Ahilnandan/Hydration_Monitoring/Hardware/Circuit_diagram.jpeg

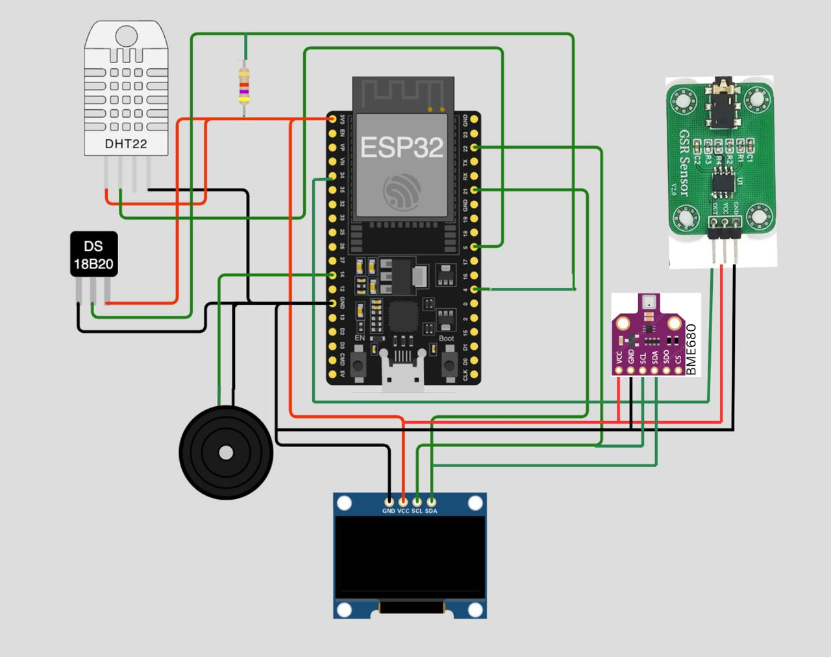
Hardware/Circuit_diagram.jpeg
