Ahilnandan/Hydration_Monitoring/Hardware/Diagram_for_Final_Product.jpg

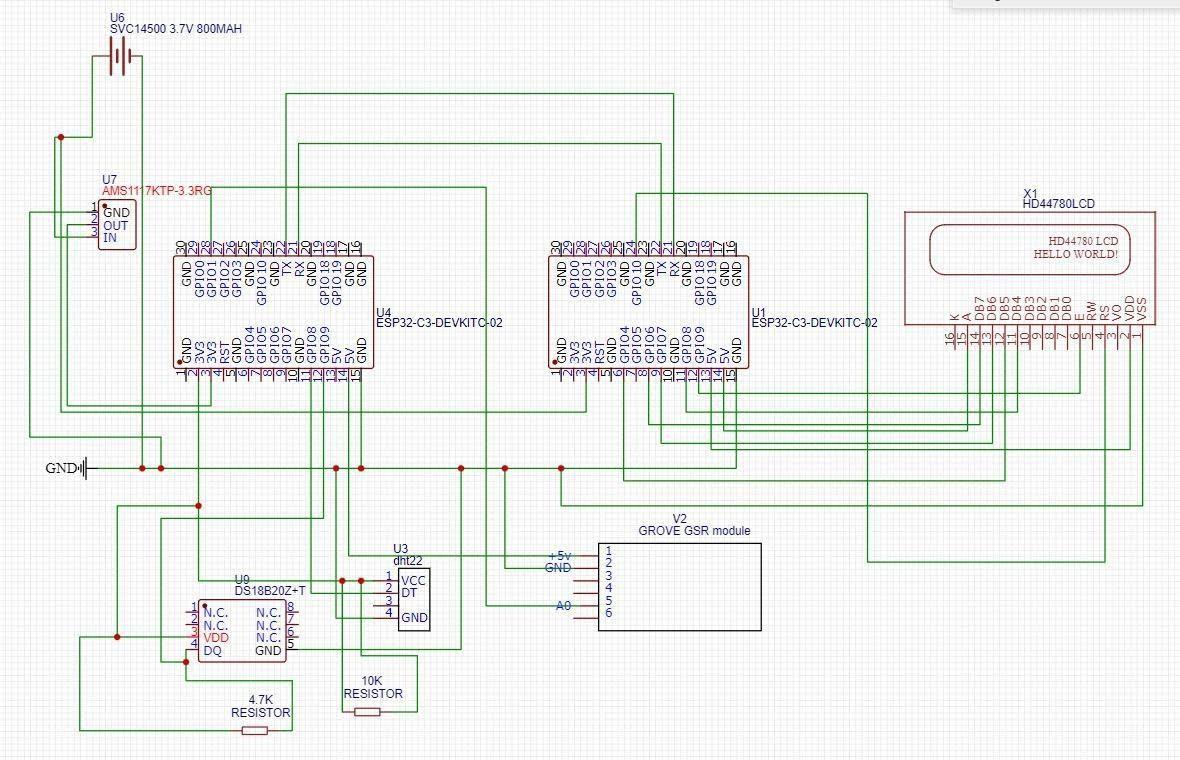
Hardware/Diagram_for_Final_Product.jpg
