Ahilnandan/Hydration_Monitoring/Hardware/Pin_Connection.jpeg

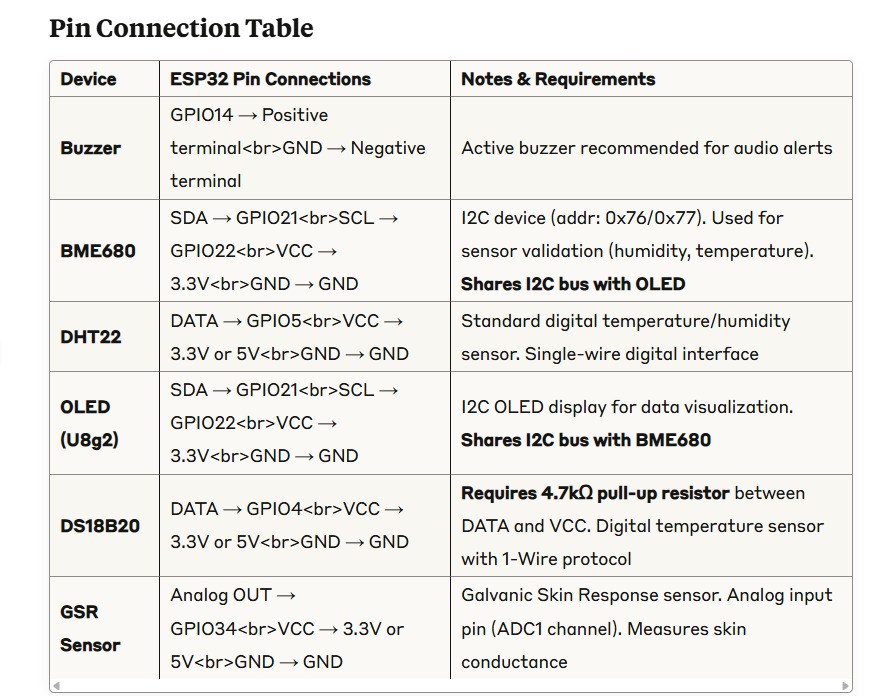
Hardware/Pin_Connection.jpeg
