Ahilnandan/Hydration_Monitoring/Hardware/Bill Of Materials.jpeg

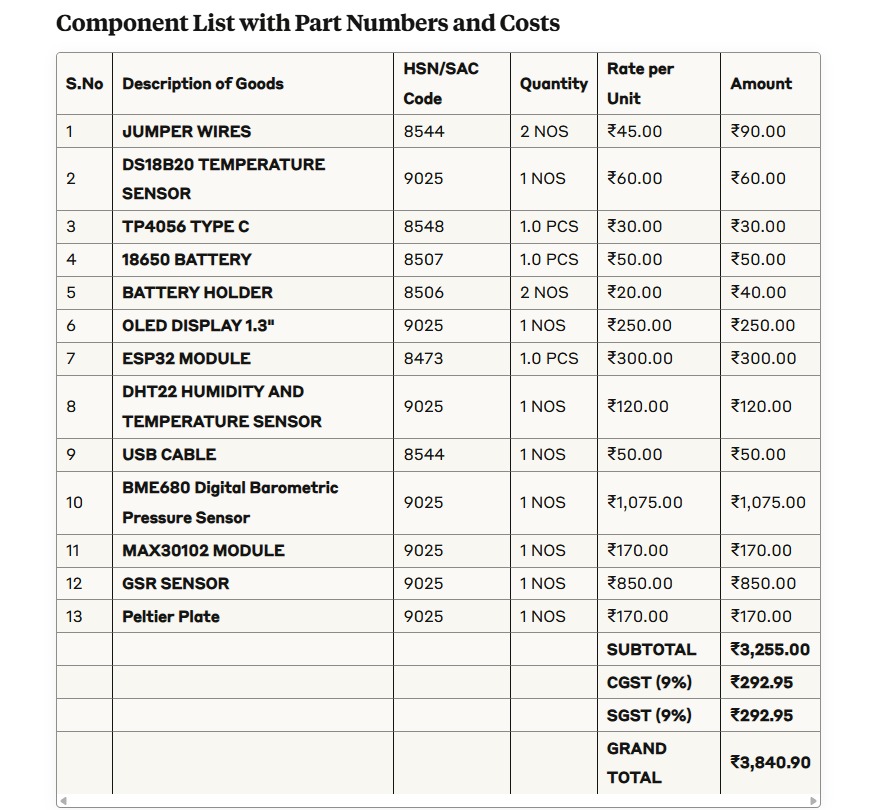
Hardware/Bill Of Materials.jpeg
