Ahilnandan/Hydration_Monitoring/drift_test_12h/log.csv

Time(ms) | GSR | DHT22_Temp(C) | DHT22_Hum(%) | DS18B20_Temp(C) | BME680_Temp(C) | BME680_Hum(%)
1 | 208 | 26.4 | 75.9 | 28.06 | 26.77 | 77.08
8 | 207 | 26.4 | 75.9 | 28.06 | 26.77 | 76.94
15 | 192 | 26.5 | 76 | 28.06 | 26.77 | 76.85
22 | 208 | 26.5 | 75.9 | 28 | 26.77 | 76.74
29 | 207 | 26.5 | 76 | 28.06 | 26.77 | 76.64
36 | 206 | 26.5 | 76 | 28 | 26.78 | 76.6
43 | 205 | 26.5 | 75.9 | 28 | 26.78 | 76.58
50 | 201 | 26.5 | 76 | 28.06 | 26.79 | 76.76
57 | 214 | 26.5 | 76 | 28.06 | 26.79 | 77.03
64 | 206 | 26.5 | 75.9 | 28.06 | 26.8 | 77.12
71 | 208 | 26.5 | 76 | 28 | 26.81 | 77.35
78 | 208 | 26.5 | 75.9 | 28.06 | 26.81 | 77.21
85 | 208 | 26.5 | 75.9 | 28.06 | 26.81 | 77.05
92 | 207 | 26.5 | 75.9 | 28.06 | 26.82 | 76.97
99 | 188 | 26.5 | 75.9 | 28 | 26.83 | 76.88
106 | 203 | 26.5 | 75.8 | 28.06 | 26.83 | 76.82
113 | 203 | 26.5 | 75.8 | 28.06 | 26.83 | 76.76
120 | 207 | 26.5 | 75.8 | 28.06 | 26.83 | 76.7
127 | 206 | 26.5 | 75.7 | 28.06 | 26.83 | 76.65
134 | 198 | 26.5 | 75.7 | 28.06 | 26.83 | 76.62
141 | 210 | 26.5 | 75.7 | 28.06 | 26.83 | 76.6
148 | 234 | 26.5 | 75.7 | 28 | 26.83 | 76.58
155 | 206 | 26.5 | 75.7 | 28.06 | 26.82 | 76.53
162 | 199 | 26.5 | 75.6 | 28 | 26.82 | 76.49
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
