Ahilnandan/Hydration_Monitoring/test_logs/DS18B20/Temperature_accuracy.csv

Time(s) | DS18B20_Temp (Â°C) | BME680_Temp (Â°C)
1 | 28.25 | 28.58
6 | 28.25 | 28.3
11 | 28.25 | 28.06
16 | 28.25 | 27.88
21 | 28.31 | 27.73
26 | 28.31 | 27.62
31 | 28.31 | 27.53
36 | 28.25 | 27.47
41 | 28.25 | 27.42
46 | 28.31 | 27.38
51 | 28.25 | 27.35
56 | 28.25 | 27.32
61 | 28.25 | 27.3
66 | 28.25 | 27.29
71 | 28.25 | 27.28
76 | 28.31 | 27.27
81 | 28.25 | 27.26
86 | 28.25 | 27.26
91 | 28.25 | 27.25
96 | 28.31 | 27.25
101 | 28.31 | 27.24
106 | 28.25 | 27.24
111 | 28.31 | 27.24
116 | 28.25 | 27.24
121 | 28.25 | 27.23
126 | 28.25 | 27.23
131 | 28.25 | 27.23
136 | 28.25 | 27.23
141 | 28.25 | 27.23
146 | 28.25 | 27.23
151 | 28.25 | 27.22
156 | 28.25 | 27.22
161 | 28.25 | 27.22
166 | 28.25 | 27.22
171 | 28.25 | 27.22
176 | 28.25 | 27.22
181 | 28.25 | 27.22
186 | 28.25 | 27.21
191 | 28.25 | 27.21
196 | 28.25 | 27.21
201 | 28.19 | 27.21
206 | 28.19 | 27.21
211 | 28.25 | 27.21
216 | 28.25 | 27.21
221 | 28.25 | 27.21
226 | 28.25 | 27.2
231 | 28.25 | 27.2
236 | 28.25 | 27.2
241 | 28.19 | 27.2
246 | 28.25 | 27.2
251 | 28.25 | 27.2
256 | 28.25 | 27.19
261 | 28.25 | 27.19
266 | 28.25 | 27.19
271 | 28.19 | 27.19
276 | 28.25 | 27.19
281 | 28.25 | 27.18
286 | 28.19 | 27.18
291 | 28.19 | 27.18
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
