Ahilnandan/Hydration_Monitoring/test_logs/DHT22/DHT22 vs BME680.csv

time | DHT22_Temp (Â°C) | BME680_Temp (Â°C)
1 | 28 | 28.37
6 | 28 | 28.37
11 | 28 | 28.38
16 | 28 | 28.38
21 | 28 | 28.39
26 | 28.1 | 28.4
31 | 28.1 | 28.41
36 | 28.1 | 28.42
41 | 28.1 | 28.43
46 | 28.1 | 28.44
51 | 28.1 | 28.45
56 | 28.1 | 28.46
61 | 28.1 | 28.47
66 | 28.1 | 28.48
71 | 28.1 | 28.49
76 | 28.1 | 28.5
81 | 28.1 | 28.51
86 | 28.1 | 28.51
91 | 28.2 | 28.52
96 | 28.2 | 28.53
101 | 28.2 | 28.54
106 | 28.2 | 28.55
111 | 28.2 | 28.55
116 | 28.2 | 28.56
121 | 28.2 | 28.56
126 | 28.2 | 28.57
131 | 28.2 | 28.57
136 | 28.2 | 28.57
141 | 28.2 | 28.57
146 | 28.2 | 28.58
151 | 28.2 | 28.58
156 | 28.2 | 28.58
161 | 28.2 | 28.58
166 | 28.2 | 28.58
171 | 28.2 | 28.58
176 | 28.2 | 28.58
181 | 28.2 | 28.58
186 | 28.2 | 28.58
191 | 28.2 | 28.58
196 | 28.2 | 28.58
201 | 28.2 | 28.57
206 | 28.2 | 28.57
211 | 28.2 | 28.57
216 | 28.2 | 28.57
221 | 28.2 | 28.56
226 | 28.2 | 28.56
231 | 28.2 | 28.56
236 | 28.2 | 28.55
241 | 28.2 | 28.55
246 | 28.2 | 28.54
251 | 28.2 | 28.54
256 | 28.2 | 28.53
261 | 28.2 | 28.53
266 | 28.2 | 28.52
271 | 28.2 | 28.52
276 | 28.2 | 28.51
281 | 28.2 | 28.51
286 | 28.2 | 28.51
291 | 28.2 | 28.5
296 | 28.2 | 28.5
301 | 28.2 | 28.49
306 | 28.2 | 28.49
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
