Ahilnandan/Hydration_Monitoring/test_logs/DHT22/Humidity_Accuracy.csv

time | DHT22_Humidity (%) | BME680_Humidity (%)
1 | 73.8 | 69.73
6 | 73.7 | 69.75
11 | 73.7 | 69.82
16 | 73.6 | 69.87
21 | 73.6 | 69.95
26 | 73.6 | 70.07
31 | 73.7 | 70.18
36 | 73.7 | 70.28
41 | 73.8 | 70.34
46 | 73.9 | 70.42
51 | 74.1 | 70.51
56 | 74.2 | 70.65
61 | 74.3 | 70.77
66 | 74.4 | 70.86
71 | 74.5 | 70.93
76 | 74.6 | 70.98
81 | 74.6 | 71.03
86 | 74.7 | 71.07
91 | 74.7 | 71.11
96 | 74.8 | 71.15
101 | 74.8 | 71.19
106 | 74.8 | 71.25
111 | 74.8 | 71.27
116 | 74.9 | 71.31
121 | 74.9 | 71.34
126 | 74.9 | 71.36
131 | 74.9 | 71.39
136 | 74.9 | 71.4
141 | 75 | 71.41
146 | 75 | 71.43
151 | 75 | 71.45
156 | 75 | 71.45
161 | 75 | 71.47
166 | 75.1 | 71.48
171 | 75.1 | 71.5
176 | 75.1 | 71.5
181 | 75.1 | 71.5
186 | 75.1 | 71.53
191 | 75.1 | 71.55
196 | 75.2 | 71.56
201 | 75.1 | 71.58
206 | 75.2 | 71.58
211 | 75.1 | 71.6
216 | 75.1 | 71.61
221 | 75.2 | 71.63
226 | 75.2 | 71.65
231 | 75.2 | 71.65
236 | 75.2 | 71.65
241 | 75.2 | 71.67
246 | 75.3 | 71.67
251 | 75.2 | 71.69
256 | 75.2 | 71.71
261 | 75.2 | 71.7
266 | 75.2 | 71.73
271 | 75.3 | 71.74
276 | 75.3 | 71.75
281 | 75.3 | 71.77
286 | 75.3 | 71.78
291 | 75.3 | 71.8
296 | 75.3 | 71.81
301 | 75.3 | 71.81
306 | 75.4 | 71.84
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
