Ahilnandan/Hydration_Monitoring/test_logs/GSR/12 hr_m_log_hum_temp_gsr.csv

Time(ms) | GSR
1 | 208
8 | 207
15 | 192
22 | 208
29 | 207
36 | 206
43 | 205
50 | 201
57 | 214
64 | 206
71 | 208
78 | 208
85 | 208
92 | 207
99 | 188
106 | 203
113 | 203
120 | 207
127 | 206
134 | 198
141 | 210
148 | 234
155 | 206
162 | 199
169 | 203
176 | 238
183 | 203
190 | 208
197 | 203
204 | 208
211 | 206
218 | 203
225 | 204
232 | 206
239 | 218
246 | 206
253 | 206
260 | 203
267 | 224
274 | 213
281 | 206
288 | 208
295 | 208
302 | 200
309 | 208
316 | 202
323 | 205
330 | 203
337 | 207
344 | 205
351 | 207
358 | 205
365 | 203
372 | 206
379 | 204
386 | 205
393 | 205
400 | 208
407 | 208
414 | 208
421 | 195
428 | 209
435 | 207
442 | 213
449 | 214
456 | 207
463 | 209
470 | 207
477 | 206
484 | 202
491 | 188
498 | 208
505 | 208
512 | 200
519 | 208
526 | 194
533 | 207
540 | 208
547 | 207
554 | 202
561 | 208
568 | 208
575 | 208
582 | 193
589 | 197
596 | 208
603 | 206
610 | 207
617 | 192
624 | 157
631 | 208
638 | 219
645 | 208
652 | 223
659 | 208
666 | 207
673 | 192
680 | 208
687 | 211
694 | 208
701 | 208
708 | 203
715 | 208
722 | 208
729 | 205
736 | 206
743 | 207
750 | 203
757 | 208
764 | 197
771 | 208
778 | 205
785 | 203
792 | 205
799 | 208
806 | 190
813 | 218
820 | 192
827 | 206
834 | 206
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
