Ahilnandan/Hydration_Monitoring/drift_test_12h/Humidity.jpg

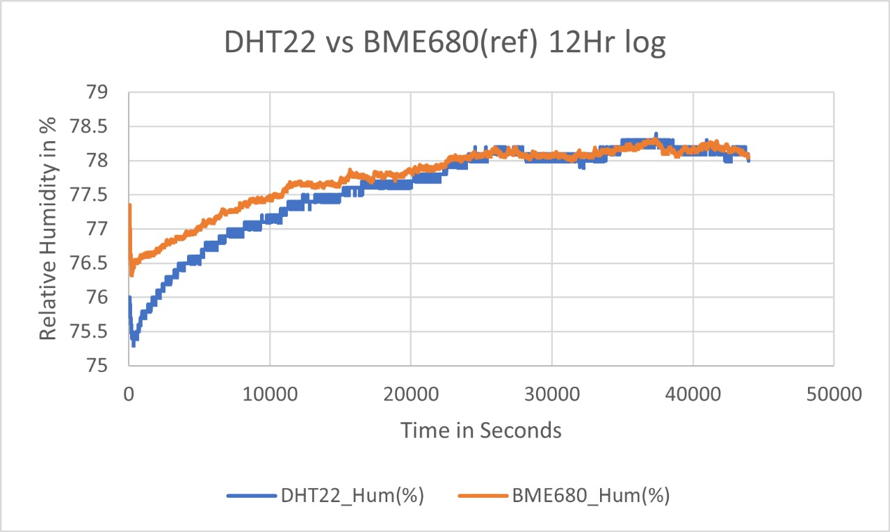
drift_test_12h/Humidity.jpg
