Ahilnandan/Hydration_Monitoring/drift_test_12h/Temperature.jpg

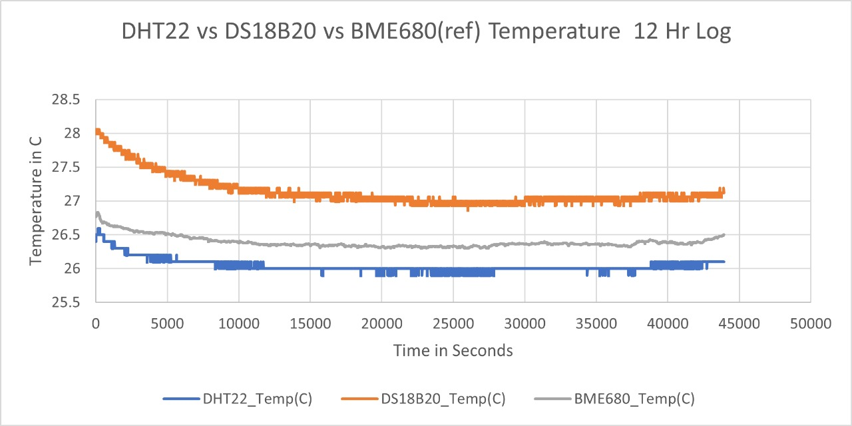
drift_test_12h/Temperature.jpg
