Ahilnandan/Hydration_Monitoring/Field_Test/Body_Temp.jpg

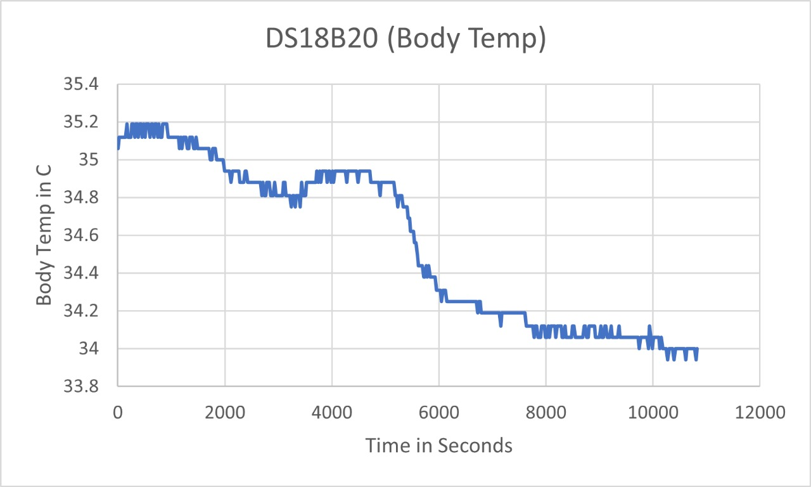
Field_Test/Body_Temp.jpg
