Ahilnandan/Hydration_Monitoring/Field_Test/WhatsApp Image 2025-07-11 at 23.14.30.jpeg

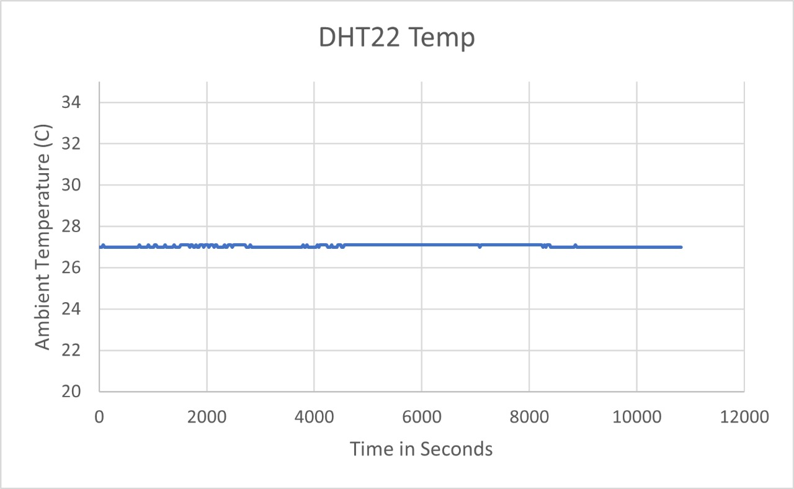
Field_Test/WhatsApp Image 2025-07-11 at 23.14.30.jpeg
