Ahilnandan/Hydration_Monitoring/test_logs/GSR/Drift.jpg

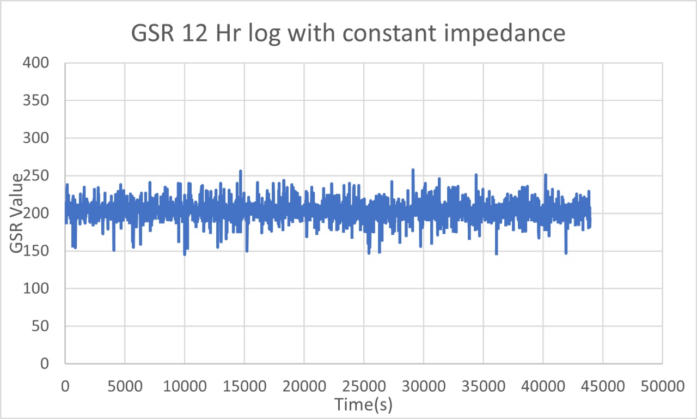
test_logs/GSR/Drift.jpg
