Ahilnandan/Hydration_Monitoring/test_logs/GSR/Precision_Raw.jpg

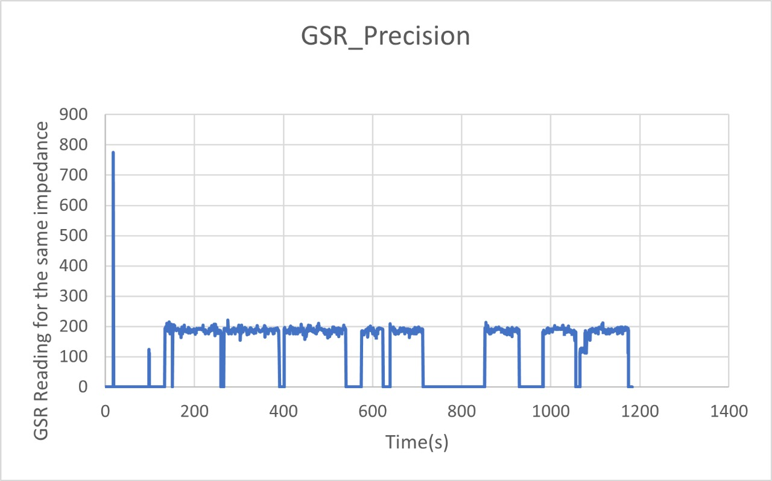
test_logs/GSR/Precision_Raw.jpg
