Ahilnandan/Hydration_Monitoring/(commit log)

2025-07-10 Rename WhatsApp Image 2025-07-10 at 13.47.19.jpeg to Circuit_diagram
2025-07-10 Rename WhatsApp Image 2025-07-10 at 14.00.38.jpeg to Bill Of Materials
2025-07-10 Rename Bill Of Materials to Bill Of Materials.jpeg
2025-07-10 Update and rename Drift to Drift.csv
    [Drift.csv]
2025-07-10 Rename WhatsApp Image 2025-07-10 at 18.47.55 (1).jpeg to Temperature_accuracy
2025-07-10 Rename WhatsApp Image 2025-07-10 at 19.02.12 (2).jpeg to Temperature_Accuracy
2025-07-10 Update and rename DHT22 vs BME680.csv to Temperature_Accuracy.csv
    [Temperature_Accuracy.csv]
2025-07-10 Update and rename DHT22 vs BME680(Temperature and Humidity).csv to Humidity_Accuracy.csv
    [Humidity_Accuracy.csv]
2025-07-10 Update and rename DS18B20 VS BME680 Temparature accuracy (1).csv to Temperature_accuracy.csv
    [Temperature_accuracy.csv]
2025-07-10 Rename WhatsApp Image 2025-07-10 at 19.18.52.jpeg to Temperature_Sensors
2025-07-10 Update and rename 12 hr_m_log_hum_temp_gsr (1).csv to Drift.csv
    [Drift.csv]
2025-07-10 Update and rename Drift.csv to log.csv
    [log.csv]
2025-07-10 Rename WhatsApp Image 2025-07-10 at 19.18.52.jpeg to Temperature.jpg
2025-07-10 Rename WhatsApp Image 2025-07-10 at 19.19.00.jpeg to Humidity.csv
    [Humidity.csv]
